htbrdd/Xerc-2-Remake/example-ir-install.jpg

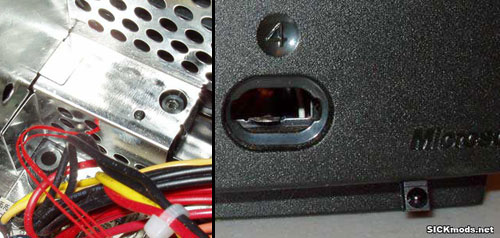
example-ir-install.jpg
