htbrdd/Xerc-2-Remake/XERC2XE-ExampleInstall-sm.jpg

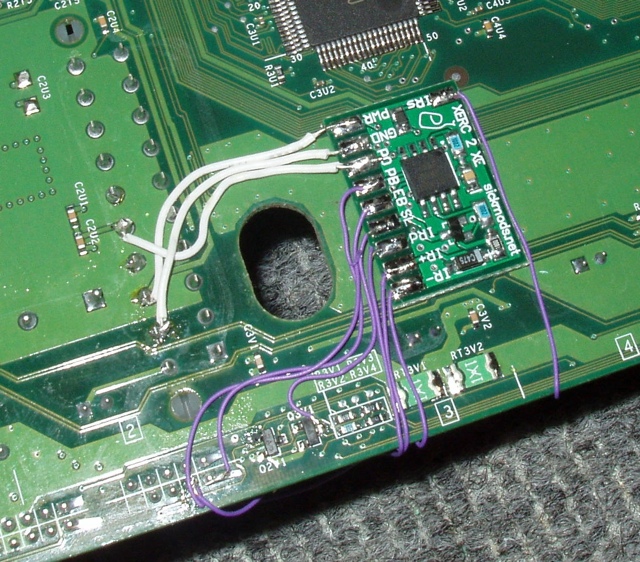
XERC2XE-ExampleInstall-sm.jpg
