htbrdd/Xerc-2-Remake/209a2b7e1f_2.jpg

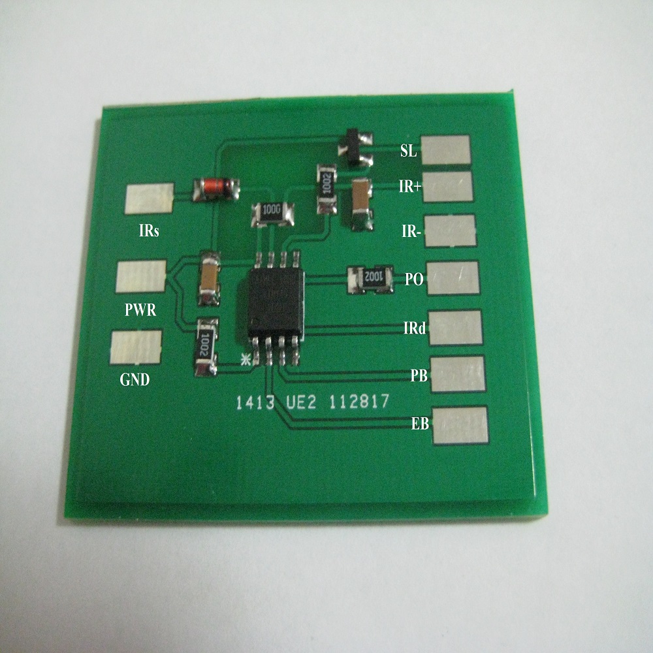
209a2b7e1f_2.jpg
