htbrdd/Xerc-2-Remake/Asset-1.jpg

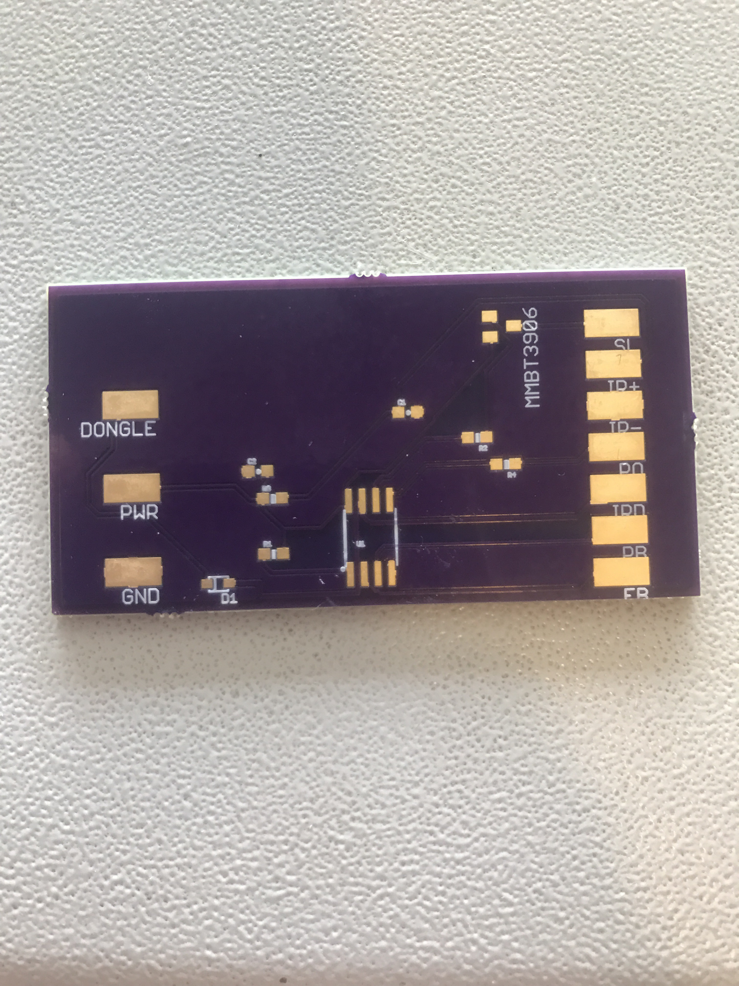
Asset-1.jpg
