htbrdd/Xerc-2-Remake/Asset.jpg

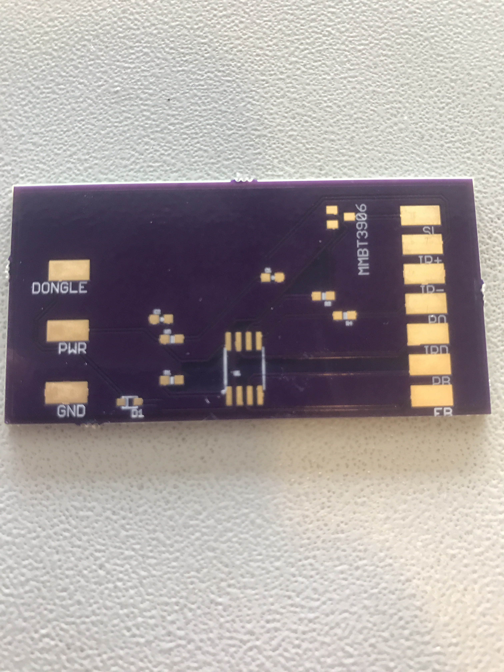
Asset.jpg
