htbrdd/Xerc-2-Remake/attinyx5_isp_schematic.png

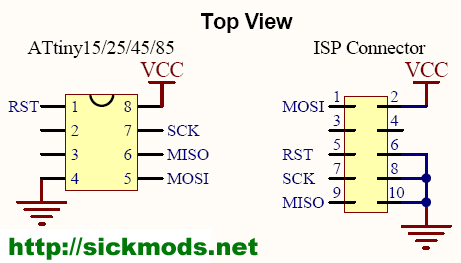
attinyx5_isp_schematic.png
