htbrdd/Xerc-2-Remake/ModeChart.gif

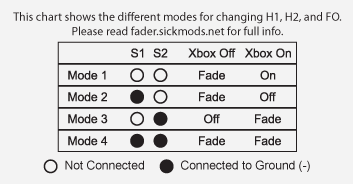
ModeChart.gif
