htbrdd/Xerc-2-Remake/MS-IR-Dongle-XE.gif

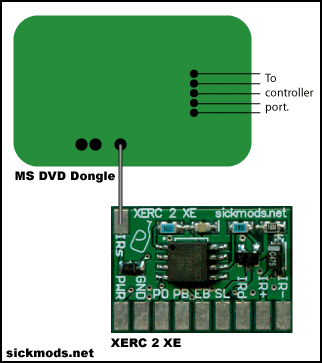
MS-IR-Dongle-XE.gif
