htbrdd/Xerc-2-Remake/xbox_pe_schematic.png

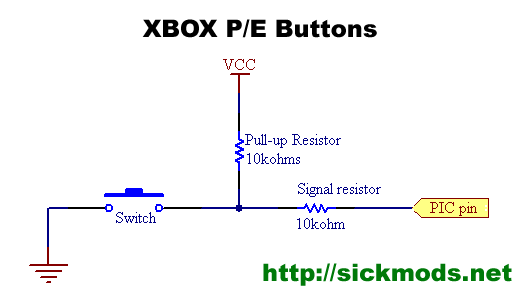
xbox_pe_schematic.png
