htbrdd/Xerc-2-Remake/xerc2_schematic.png

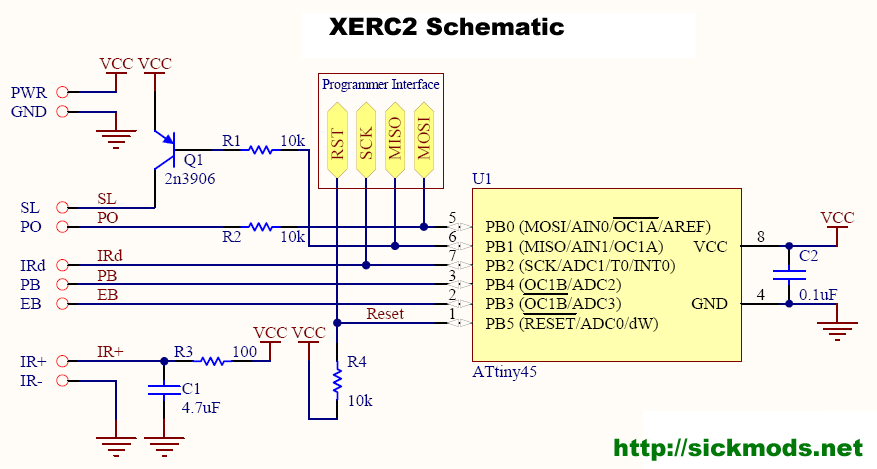
xerc2_schematic.png
