htbrdd/Xerc-2-Remake/XERC2XE-big.jpg

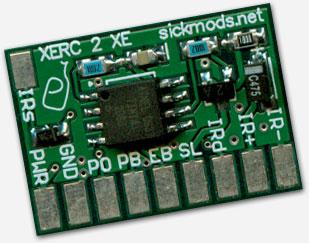
XERC2XE-big.jpg
