htbrdd/Xerc-2-Remake/XERCCMESE-Image.jpg

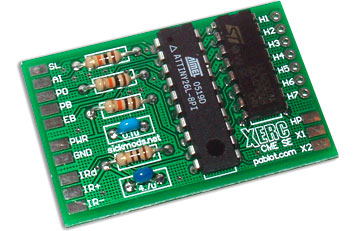
XERCCMESE-Image.jpg
