htbrdd/Xerc-2-Remake/XERC2-InstallDiagram.jpg

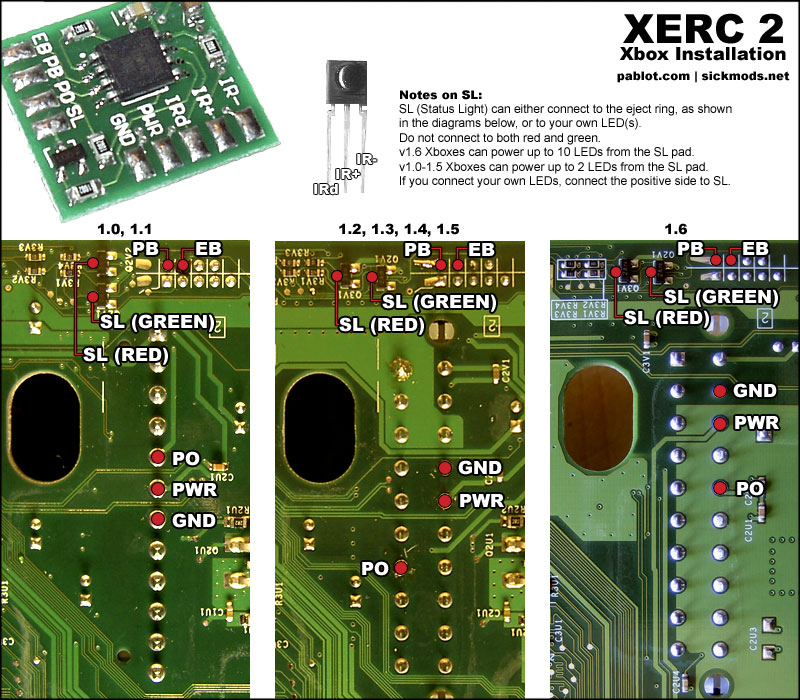
XERC2-InstallDiagram.jpg
