htbrdd/Xerc-2-Remake/XERC2XE-InstallDiagram.jpg

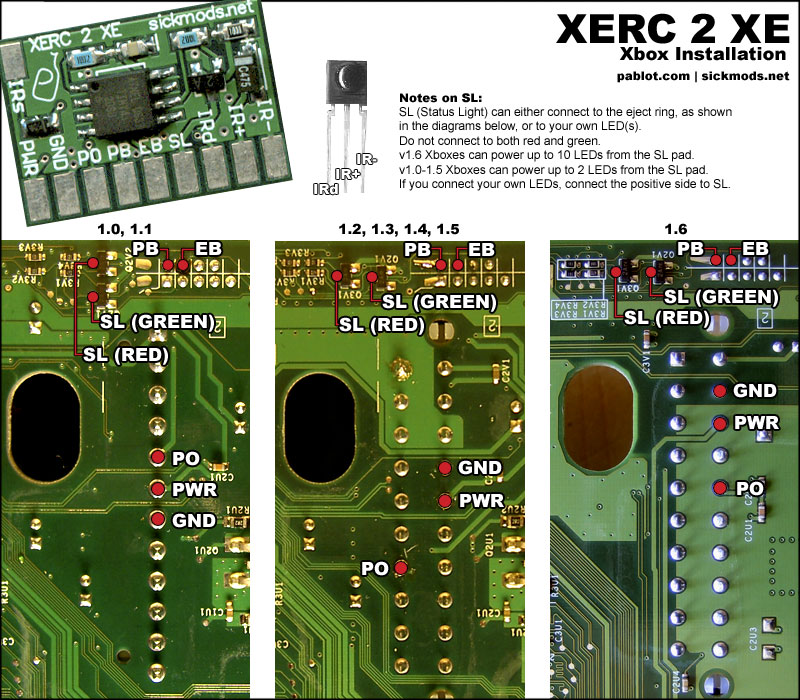
XERC2XE-InstallDiagram.jpg
