htbrdd/Xerc-2-Remake/Xerc2/xerc2-1.brd

## EAGLE design Xerc2/xerc2-1.brd (2017-04-23)

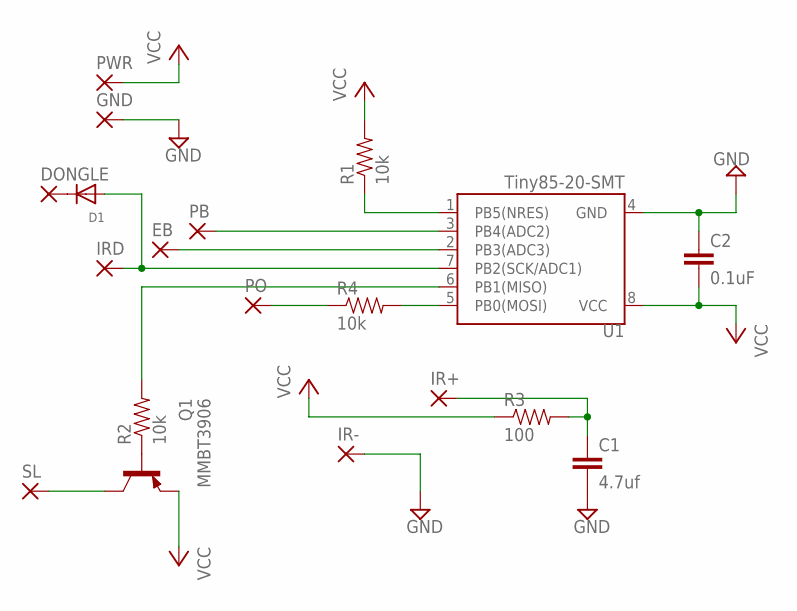
[picture p34: schematic xerc2-1.sch]

Parts:
C1: 4.7uf; 0603-CAP
C2: 0.1uF; 0603-CAP
D1: DIODESOD-323F; SOD-323F
DONGLE: SMD5; SMD2,54-5,08
EB: SMD5; SMD2,54-5,08
GND: SMD5; SMD2,54-5,08
IR+: SMD5; SMD2,54-5,08
IR-: SMD5; SMD2,54-5,08
IRD: SMD5; SMD2,54-5,08
MMBT3906: Q1; SOT23
PB: SMD5; SMD2,54-5,08
PO: SMD5; SMD2,54-5,08
PWR: SMD5; SMD2,54-5,08
R1, R2, R4: 10k; 0603-RES
R3: 100; 0603-RES
SL: SMD5; SMD2,54-5,08
U1: Tiny85-20-SMT; SO08-EIAJ

Connections:
GND: C1.2, C2.1, GND.1, IR-.1, U1.4 (GND)
unnamed: PB.1, U1.3 (PB4(ADC2))
unnamed: R1.1, U1.1 (PB5(NRES))
unnamed: EB.1, U1.2 (PB3(ADC3))
unnamed: D1.A, IRD.1, U1.7 (PB2(SCK/ADC1))
unnamed: R2.2, U1.6 (PB1(MISO))
unnamed: MMBT3906.1 (B), R2.1
unnamed: MMBT3906.3 (C), SL.1
unnamed: C1.1, IR+.1, R3.2
unnamed: R4.2, U1.5 (PB0(MOSI))
unnamed: PO.1, R4.1
unnamed: D1.C, DONGLE.1
VCC: C2.2, MMBT3906.2 (E), PWR.1, R1.2, R3.1, U1.8 (VCC)

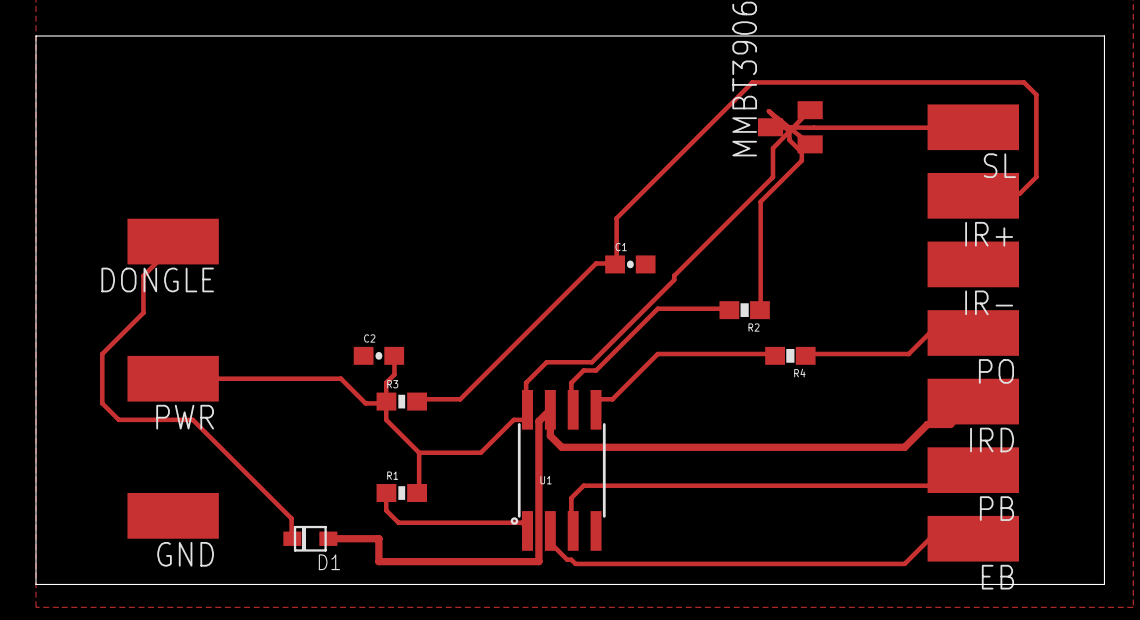
[picture p35: board xerc2-1.brd from above]

Board: 2 copper layers, 59.4 x 30.5 mm, 19 parts (0 on the bottom side), 13 nets.
