htbrdd/Xerc-2-Remake/(commit log)

2017-04-23 Board files
    [xerc2-0.brd, xerc2-1-.brd, xerc2-1.brd, xerc2-1.sch, xerc2-2.brd, xerc2-3.brd, xerc2-4.brd, xerc2-5.brd]
2017-04-24 added icsp header to board
    [xerc2-3-2.brd, xerc2-3-2.sch, xerc3-1.brd, xerc3-1.sch]
2017-05-06 bom lists
